czstara12/lckfb-daplink/4_docs/images/image-20240612184925933.png

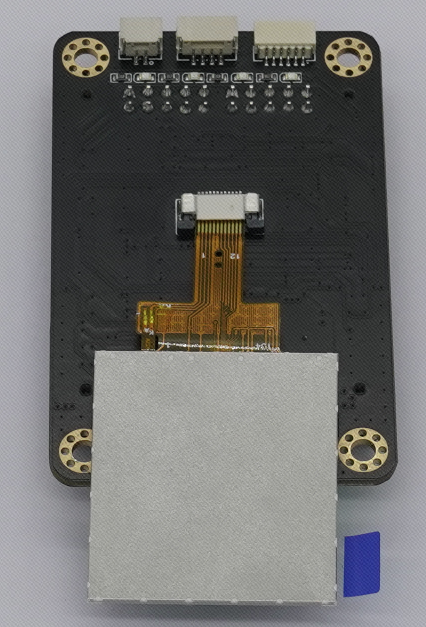
4_docs/images/image-20240612184925933.png
