czstara12/lckfb-daplink/3_3D model/下壳20240522.STEP

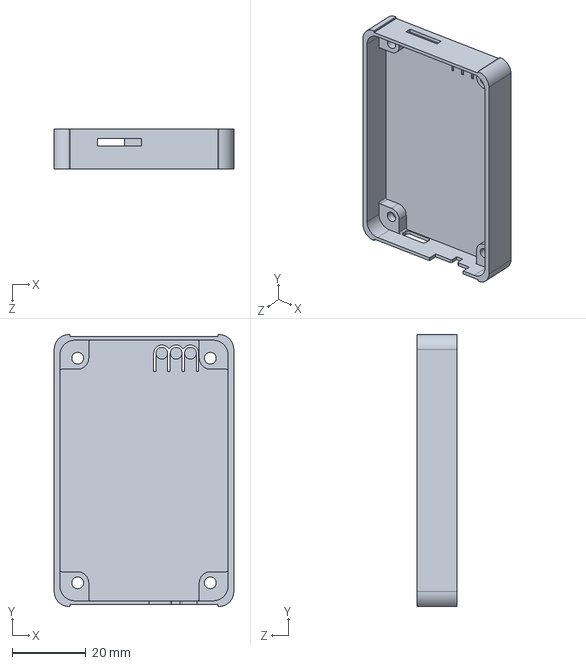
[picture p74: CAD file, 2024-06-13]
3_3D model/下壳20240522.STEP
48.6 x 73.6 x 10.9 mm
