czstara12/lckfb-daplink/3_3D model/一体按钮20240522.STEP

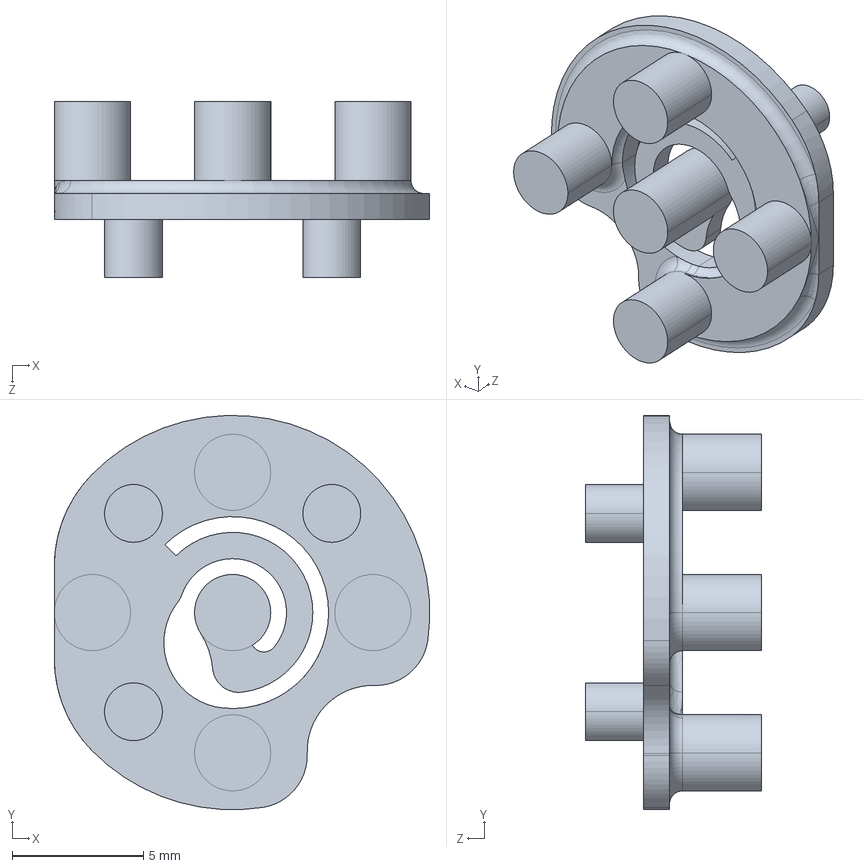
[picture p75: CAD file, 2024-06-13]
3_3D model/一体按钮20240522.STEP
14.3 x 15.0 x 6.70 mm
