czstara12/lckfb-daplink/3_3D model/上壳20240522.STEP

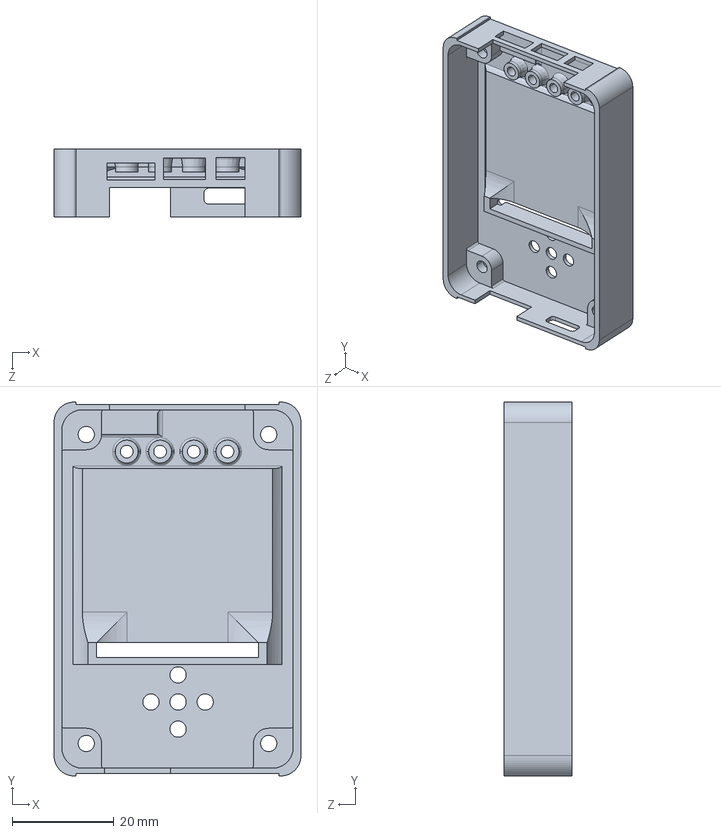
[picture p76: CAD file, 2024-06-13]
3_3D model/上壳20240522.STEP
48.6 x 73.6 x 13.3 mm
