czstara12/lckfb-daplink/4_docs/0_组装文档.md

# 物料清单

想要组装一个成品的多功能调试工具，需要准备如下物料：

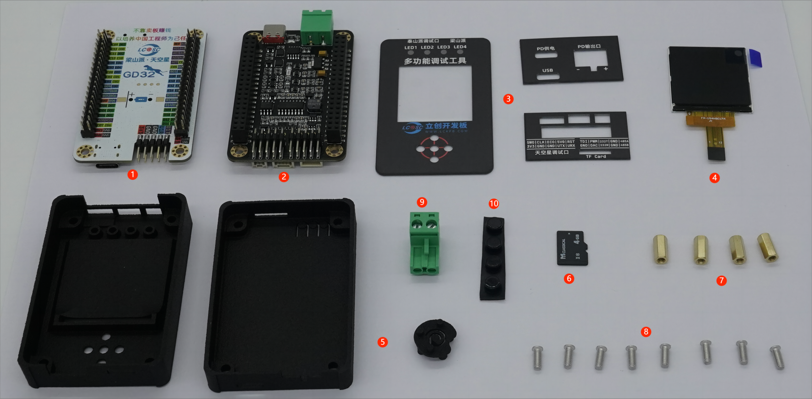
[picture p77: 4_docs/images/bom.png]
bom


| 序号 | 描述 | 获取途径 |
| :--: | :---: | :---: |
|  1 | 立创·天空星开发板-GD32F407VET6-青春版，焊接好朝下的排针。 | [购买链接](https://lckfb.com/project/detail/lckfb-lspi-skystar-gd32f407vet6-lite?param=baseInfo) |
|  2 | 立创DAPLINK调试工具扩展板 | [购买链接](https://item.szlcsc.com/24149614.html) |
|  3 | 面板  透明亚克力,底面,0.5mm,3M9448A(通用款),强遮光 | 在硬件开源地址中找到面板源文件，自行DIY外观后到[立创商城进行面板定制](https://dos.szlcsc.com/home.html) |
|  4 | 1.54寸240x240高清ips lcd显示屏-胶铁一体背光 | [购买链接](https://item.taobao.com/item.htm?spm=a1z09.2.0.0.53312e8dsg8GNX&id=675191199166&_u=c1q1nrd11cb3) |
|  5 | 3D打印外壳 【上壳】-【下壳】-【一体按钮】 | 在开源仓库找到模型文件，到[三维猴下单](https://www.jlc-3dp.cn/swhorder/#/placeOrder)，选自己喜欢的材料。 |
|  6 | TF卡 | [购买链接](https://item.szlcsc.com/8422935.html) |
|  7 | M3*10 铜柱x4 | [购买链接](https://detail.tmall.com/item.htm?id=542213588710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) |
|  8 | M3*8 头4.0 沉头螺丝x8 | [购买链接](https://detail.tmall.com/item.htm?id=756810204825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) |
|  9 | WJ2EDGK-5.08-2P 插拔式接线端子 | [购买链接](https://item.szlcsc.com/72476.html) |
|  10  | XG-0603【6*3mm】 自粘式防滑脚垫x4 | [购买链接](https://item.taobao.com/item.htm?id=626062804142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) |

# 开始组装

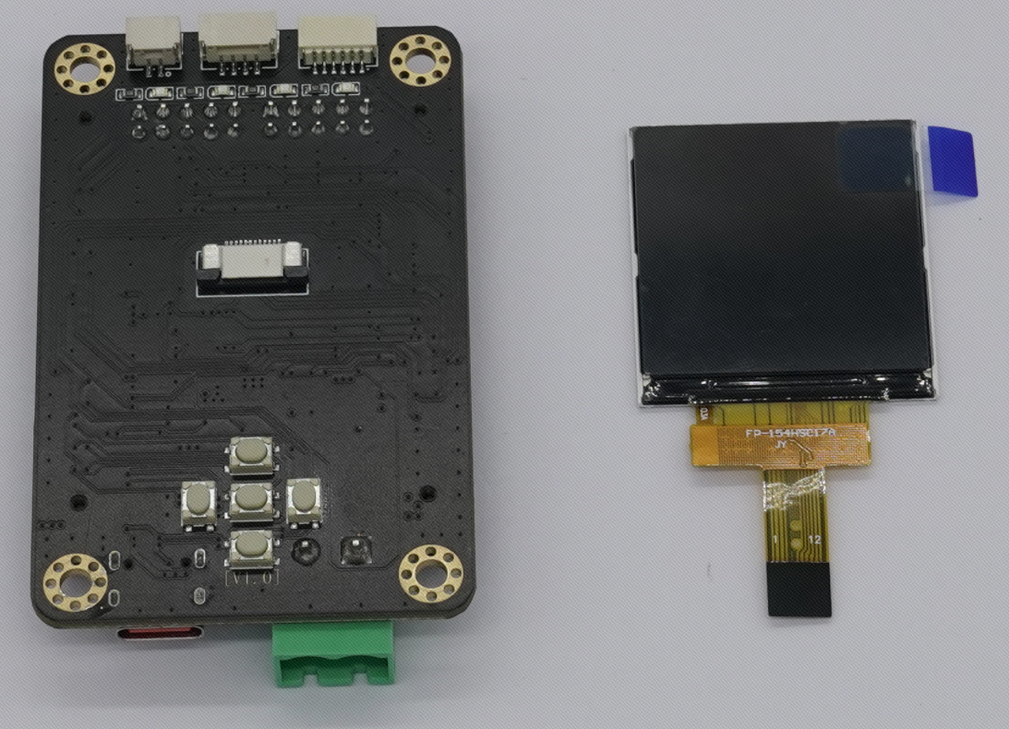
[picture p78: 4_docs/images/image-20240612184800780.png]
1. 拿出扩展板和屏幕。

2. 将屏幕FPC排线的金手指朝上插入扩展板的座子里面，插到位置后锁紧。

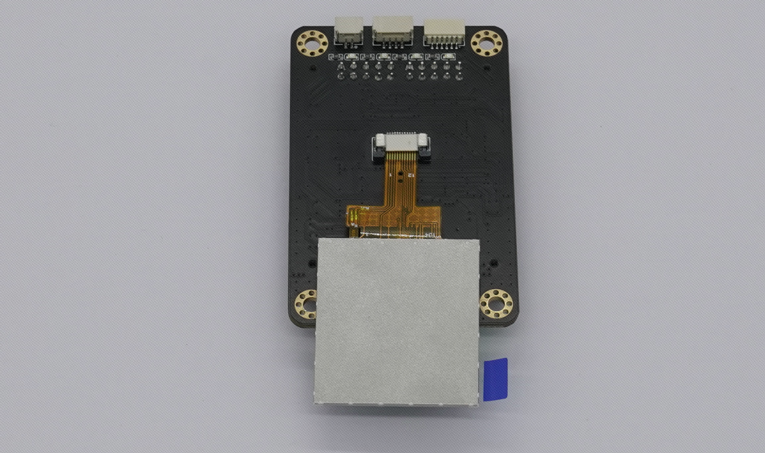
[picture p79: 4_docs/images/image-20240612192124184.png]


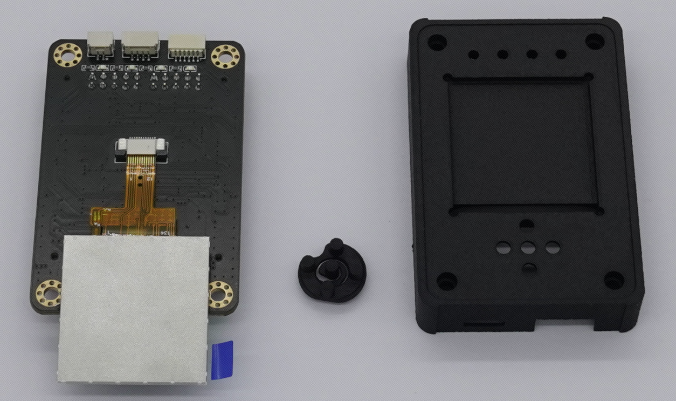
[picture p80: 4_docs/images/image-20240612185113671.png]
3. 拿出3D打印的上壳和一体按钮。

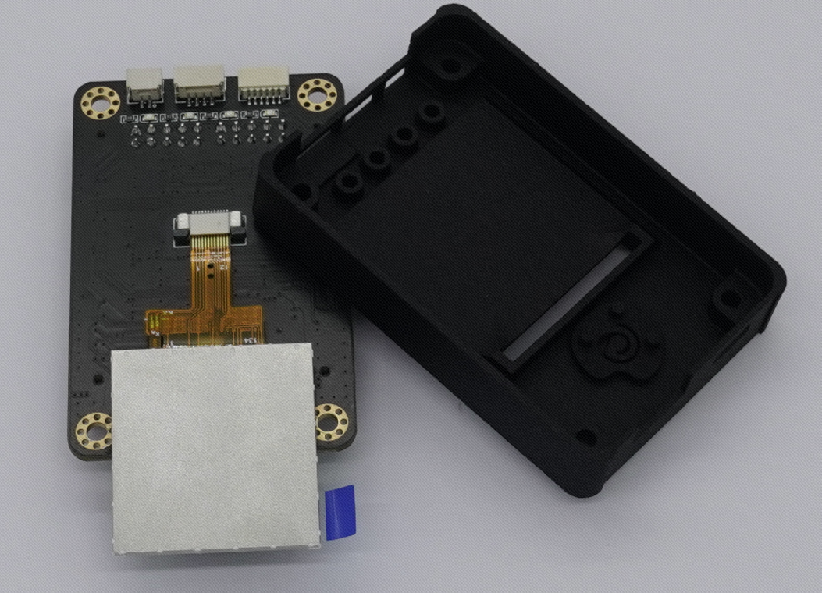
[picture p81: 4_docs/images/image-20240612185205591.png]
4. 将一体按钮如图所示塞入上壳中。

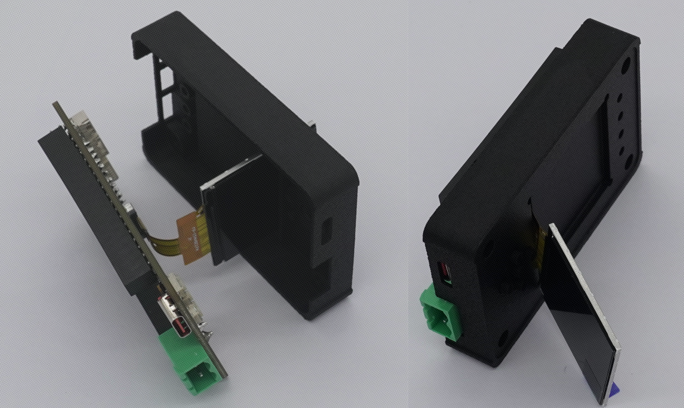
[picture p82: 4_docs/images/image-20240612185405428.png]
5. 将屏幕从上壳中间的凹槽中穿过。

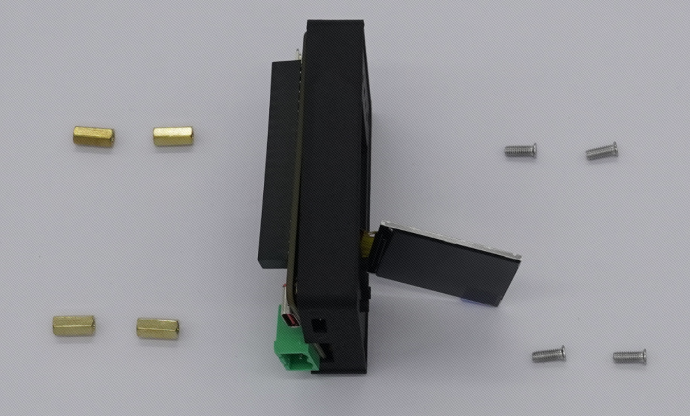
[picture p83: 4_docs/images/image-20240612185631966.png]
6. 拿出4颗【M3x10】铜柱和四颗【M3x8 头4.0】沉头螺丝。

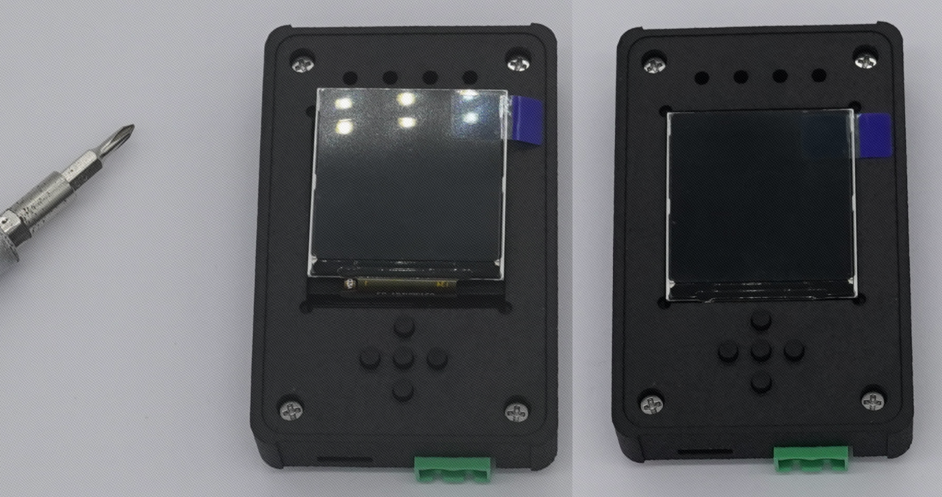
[picture p84: 4_docs/images/image-20240612185855640.png]
7. 铜柱在下，沉头螺丝在上，用十字螺丝刀将扩展板和上壳固定，固定好后如图右所示将屏幕塞入上壳凹槽内即可。

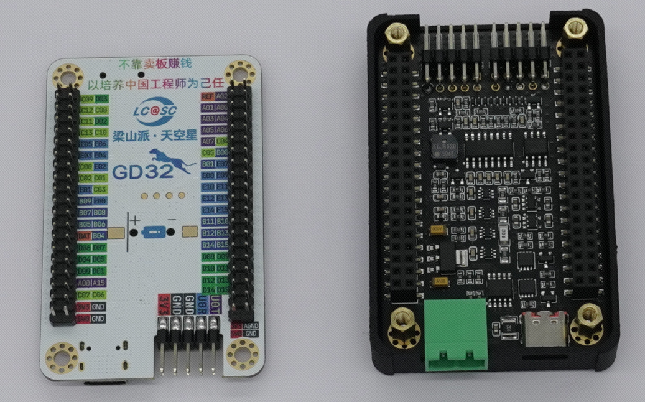
[picture p85: 4_docs/images/image-20240612185936141.png]
8. 拿出GD32版本的天空星。

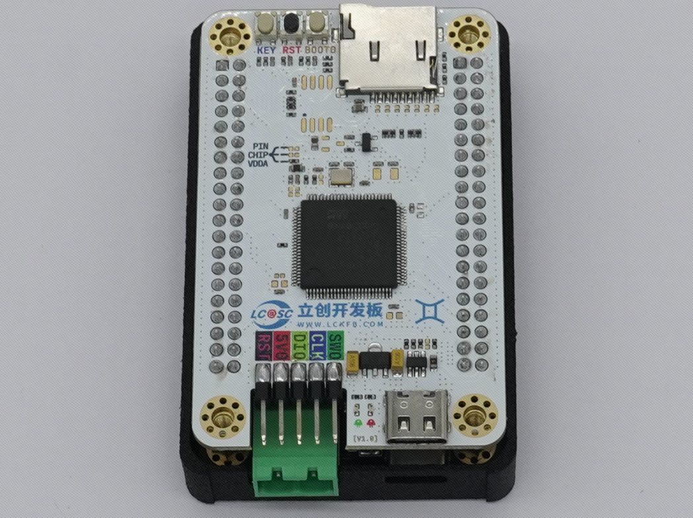
[picture p86: 4_docs/images/image-20240612190027443.png]
9. 按下图所示插入扩展板的双排母内。

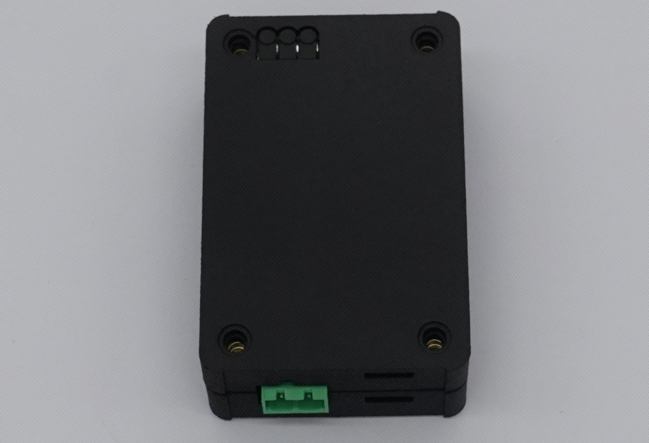
[picture p87: 4_docs/images/image-20240612190126970.png]
10. 将下壳盖到天空星上面。

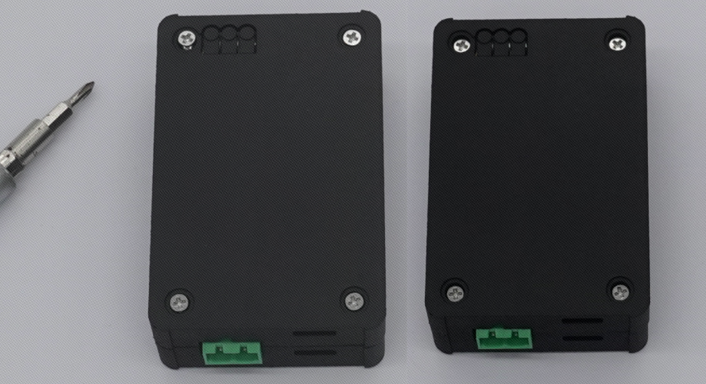
[picture p88: 4_docs/images/image-20240612190321722.png]
11. 在四个螺丝孔内放入四颗【M3x8 头4.0】沉头螺丝，并用螺丝刀拧紧。

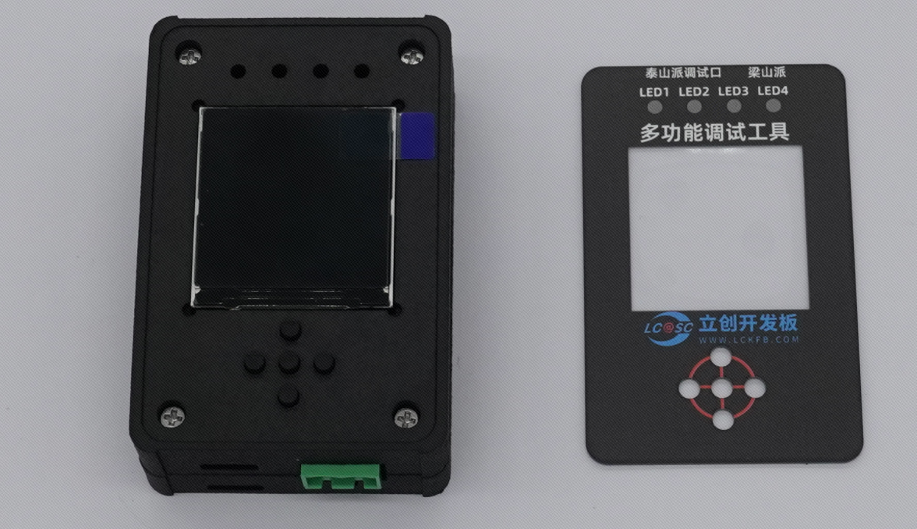
[picture p89: 4_docs/images/image-20240612190531208.png]
12. 将多功能调试器翻面，拿出正面面板。

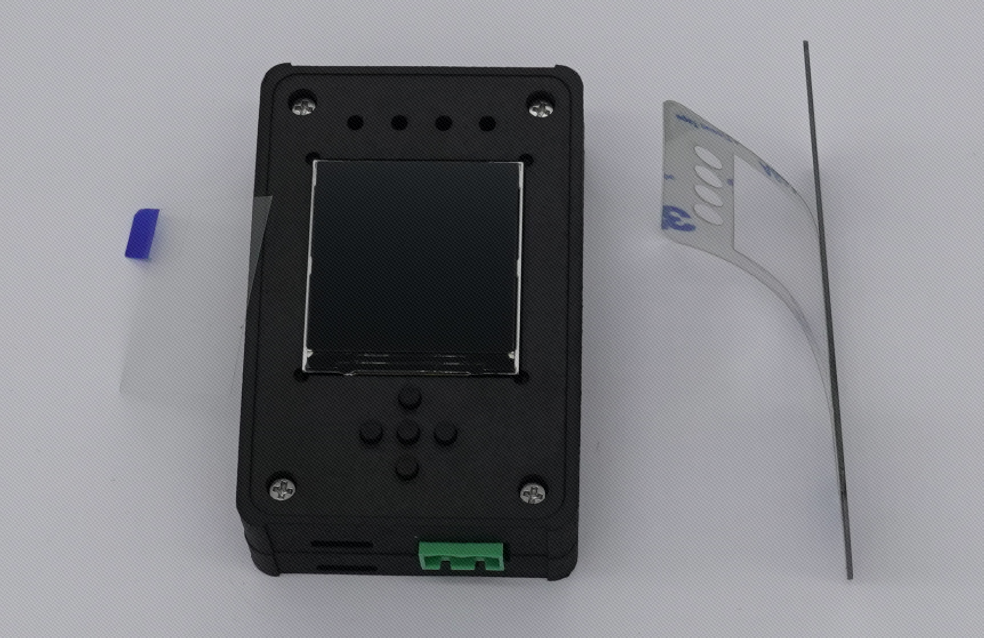
[picture p90: 4_docs/images/image-20240612190643587.png]
13. 撕掉屏幕的保护膜，撕掉面板的背胶保护膜。

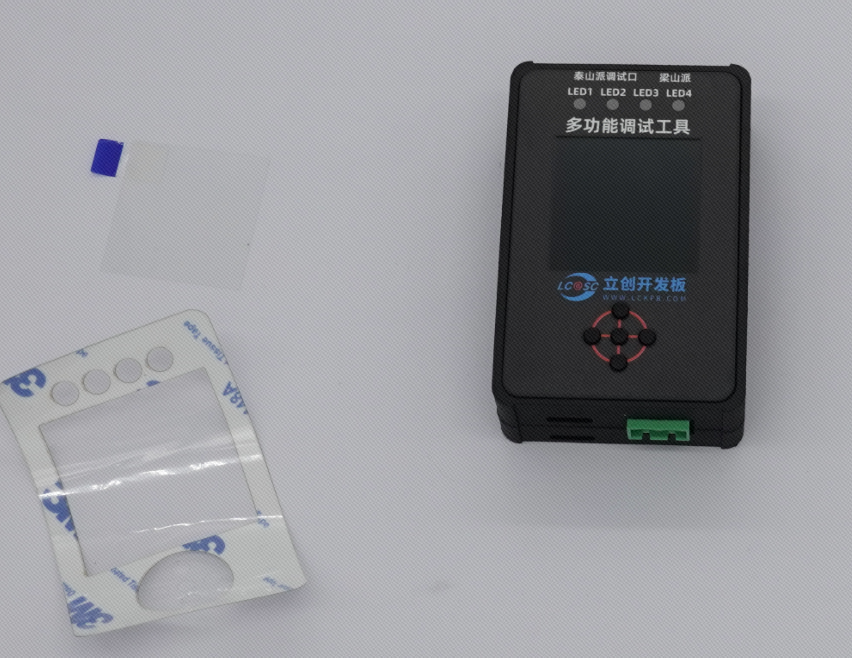
[picture p91: 4_docs/images/image-20240612190745032.png]
14. 将面板嵌入上壳的凹槽内，注意对齐按钮孔位。

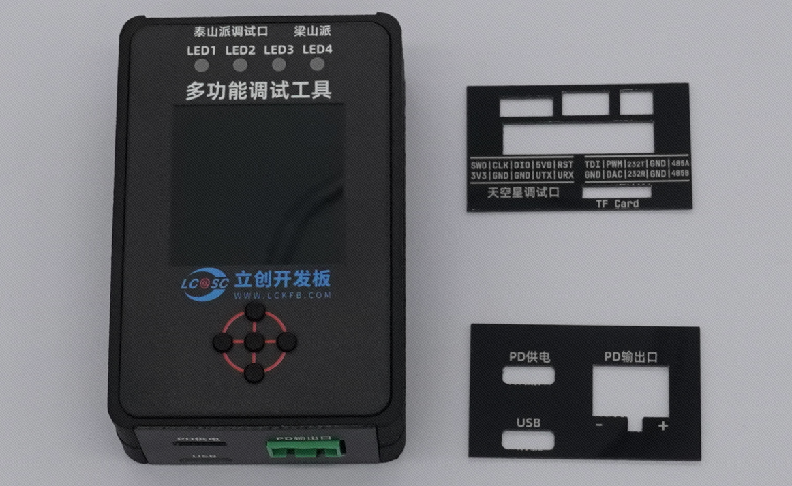
[picture p92: 4_docs/images/image-20240612191203407.png]
15. 按照之前操作，撕掉面板背胶保护膜后一并安装侧面面板。

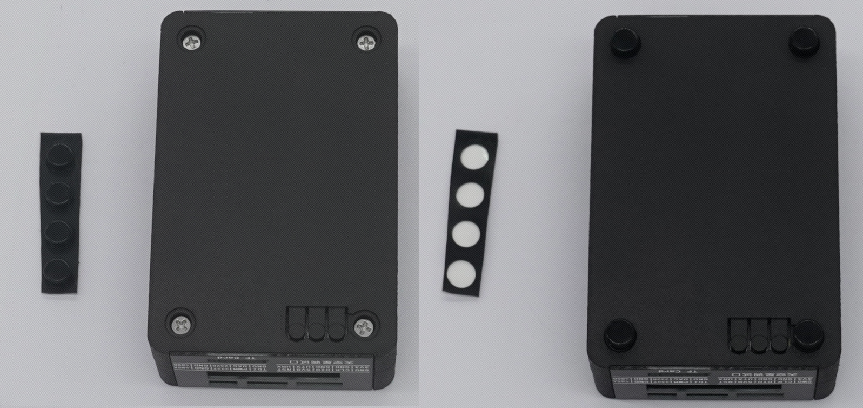
[picture p93: 4_docs/images/image-20240612191402218.png]
16. 拿出防滑脚垫，将四颗脚垫按入下壳的固定孔位中。

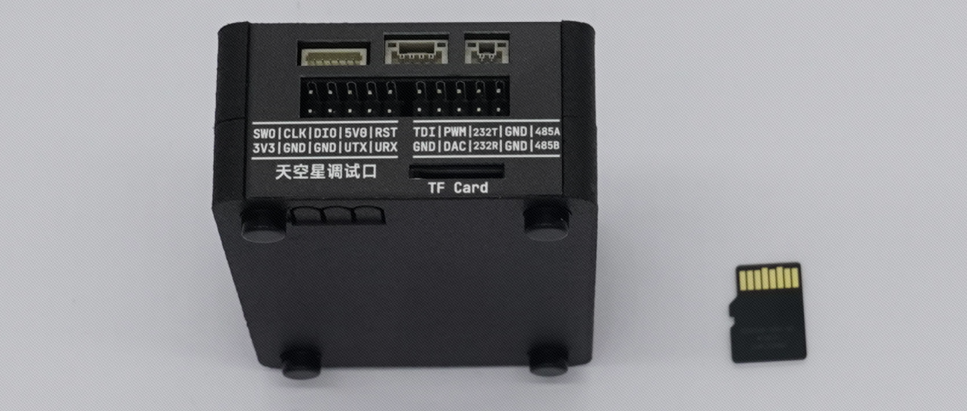
[picture p94: 4_docs/images/image-20240612191523456.png]
17. 拿出已经写入芯片下载算法和待下载固件的TF卡。

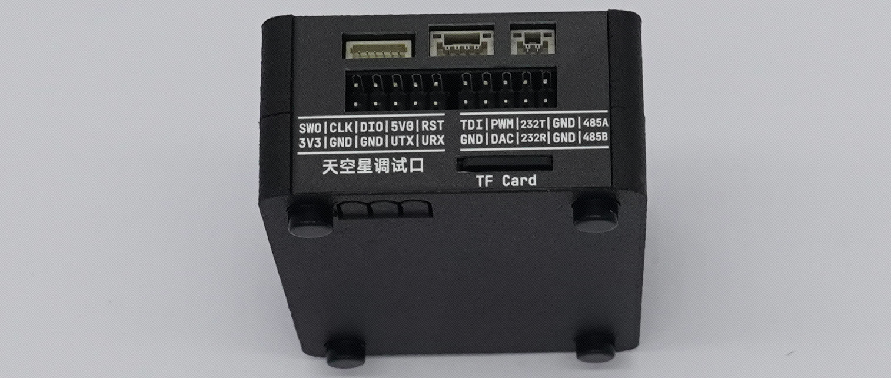
[picture p95: 4_docs/images/image-20240612191607908.png]
18. 将TF卡插入卡槽中。

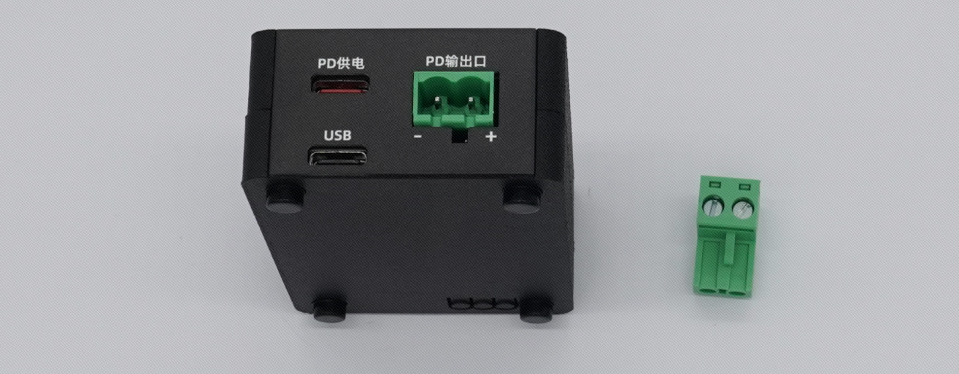
[picture p96: 4_docs/images/image-20240612191700006.png]
19. 拿出插拔式接线端子。

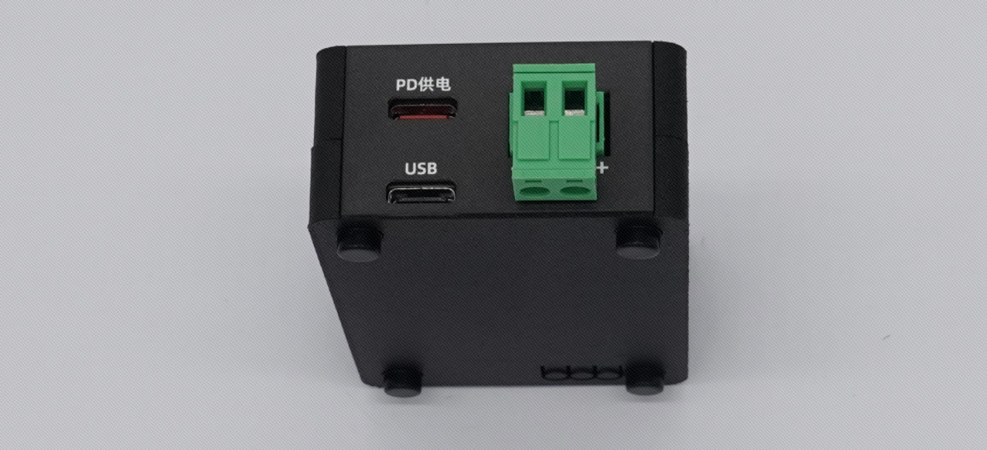
[picture p97: 4_docs/images/image-20240612191744928.png]
20. 插入PD输出口方便我们后期接线使用。

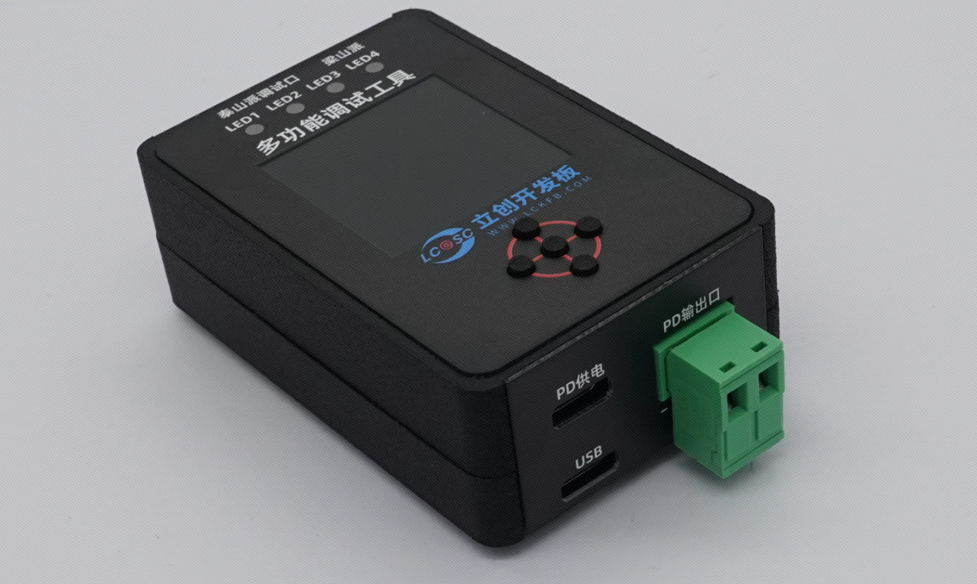
[picture p98: 4_docs/images/image-20240612191912833.png]
21. 装好后的实物图如下所示：
