czstara12/lckfb-daplink/1_Code/STM32F407/board/CubeMX_Config/CubeMX_Config.ioc

Mcu.UserName=STM32F407VETx
PA10.Signal=USART1_RX
PA11.Signal=USB_OTG_FS_DM
PA12.Signal=USB_OTG_FS_DP
PA13.Signal=SYS_JTMS-SWDIO
PA14.Signal=SYS_JTCK-SWCLK
PA3.GPIO_Label=I_PD_OUT_MEASURE2
PA3.Signal=ADCx_IN3
PB1.GPIO_Label=SPI_FLASH_CS
PB1.Signal=GPIO_Output
PA4.GPIO_Label=DAC_OUT
PA4.Signal=COMP_DAC1_group
PA9.Signal=USART1_TX
PB12.GPIO_Label=LCD_CS
PB12.Signal=GPIO_Output
PB13.GPIO_Label=LCD_SCL
PB13.Signal=SPI2_SCK
PB14.GPIO_Label=LCD_BLK
PB14.Signal=GPIO_Output
PB15.GPIO_Label=LCD_SDA
PB15.Signal=SPI2_MOSI
PB2.GPIO_Label=USER_LED
PB2.Signal=GPIO_Output
PB3.Signal=SYS_JTDO-SWO
PB9.GPIO_Label=BEEP_PWM
PB9.Signal=S_TIM4_CH4
PC0.GPIO_Label=V_5V0_OUT_MEASURE
PC0.Signal=ADCx_IN10
PC1.GPIO_Label=I_5V0_OUT_MEASURE
PC1.Signal=ADCx_IN11
PC10.Signal=SDIO_D2
PC11.Signal=SDIO_D3
PC12.Signal=SDIO_CK
PC2.GPIO_Label=V_3V3_OUT_MEASURE
PC2.Signal=ADCx_IN12
PC3.GPIO_Label=I_3V3_OUT_MEASURE
PC3.Signal=ADCx_IN13
PC4.GPIO_Label=V_PD_OUT_MEASURE
PC4.Signal=ADCx_IN14
PC5.GPIO_Label=I_PD_OUT_MEASURE1
PC5.Signal=ADCx_IN15
PC8.Signal=SDIO_D0
PC9.Signal=SDIO_D1
PD2.Signal=SDIO_CMD
PD3.GPIO_Label=SD_CARD_DET
PD3.Signal=GPIO_Input
PD6.GPIO_Label=TDO(SWO)
PD6.Signal=GPIO_Input
PD8.GPIO_Label=CDC_TX
PD8.Signal=USART3_TX
PD9.GPIO_Label=CDC_RX
PD9.Signal=USART3_RX
PE10.GPIO_Label=NRST
PE10.Signal=GPIO_Output
PE12.GPIO_Label=TDI
PE12.Signal=GPIO_Output
PE7.GPIO_Label=TCK/SWCLK
PE7.Signal=GPIO_Output
PE8.GPIO_Label=TMS/SWDIO
PE8.Signal=GPIO_Output
PE9.GPIO_Label=PWM_OUT
PE9.Signal=S_TIM1_CH1
PH0-OSC_IN.Signal=RCC_OSC_IN
PH1-OSC_OUT.Signal=RCC_OSC_OUT
