czstara12/lckfb-daplink/1_Code/STM32F407/rtconfig.h

#ifndef RT_CONFIG_H__
#define RT_CONFIG_H__

#define SOC_STM32F407VE
#define BOARD_STM32F407_LCKFB

/* RT-Thread Kernel */

/* klibc options */

/* rt_vsnprintf options */

/* end of rt_vsnprintf options */

/* rt_vsscanf options */

/* end of rt_vsscanf options */

/* rt_memset options */

/* end of rt_memset options */

/* rt_memcpy options */

/* end of rt_memcpy options */

/* rt_memmove options */

/* end of rt_memmove options */

/* rt_memcmp options */

/* end of rt_memcmp options */

/* rt_strstr options */

/* end of rt_strstr options */

/* rt_strcasecmp options */

/* end of rt_strcasecmp options */

/* rt_strncpy options */

/* end of rt_strncpy options */

/* rt_strcpy options */

/* end of rt_strcpy options */

/* rt_strncmp options */

/* end of rt_strncmp options */

/* rt_strcmp options */

/* end of rt_strcmp options */

/* rt_strlen options */

/* end of rt_strlen options */

/* rt_strnlen options */

/* end of rt_strnlen options */
/* end of klibc options */
#define RT_NAME_MAX 32
#define RT_CPUS_NR 1
#define RT_ALIGN_SIZE 8
#define RT_THREAD_PRIORITY_32
#define RT_THREAD_PRIORITY_MAX 32
#define RT_TICK_PER_SECOND 1000
#define RT_USING_OVERFLOW_CHECK
#define RT_USING_HOOK
#define RT_HOOK_USING_FUNC_PTR
#define RT_USING_IDLE_HOOK
#define RT_IDLE_HOOK_LIST_SIZE 4
#define IDLE_THREAD_STACK_SIZE 1024

/* kservice options */

/* end of kservice options */
#define RT_USING_DEBUG
#define RT_DEBUGING_ASSERT
#define RT_DEBUGING_COLOR
#define RT_DEBUGING_CONTEXT

/* Inter-Thread communication */

#define RT_USING_SEMAPHORE
#define RT_USING_MUTEX
#define RT_USING_EVENT
#define RT_USING_MAILBOX
#define RT_USING_MESSAGEQUEUE
/* end of Inter-Thread communication */

/* Memory Management */

#define RT_USING_MEMPOOL
#define RT_USING_SMALL_MEM
#define RT_USING_SMALL_MEM_AS_HEAP
#define RT_USING_HEAP
/* end of Memory Management */
#define RT_USING_DEVICE
#define RT_USING_DEVICE_OPS
#define RT_USING_CONSOLE
#define RT_CONSOLEBUF_SIZE 128
#define RT_CONSOLE_DEVICE_NAME "uart1"
#define RT_VER_NUM 0x50201
#define RT_BACKTRACE_LEVEL_MAX_NR 32
/* end of RT-Thread Kernel */
#define RT_USING_HW_ATOMIC
#define RT_USING_CPU_FFS
#define ARCH_ARM
#define ARCH_ARM_CORTEX_M
#define ARCH_ARM_CORTEX_M4

/* RT-Thread Components */

#define RT_USING_COMPONENTS_INIT
#define RT_USING_USER_MAIN
#define RT_MAIN_THREAD_STACK_SIZE 2048
#define RT_MAIN_THREAD_PRIORITY 10
#define RT_USING_LEGACY
#define RT_USING_MSH
#define RT_USING_FINSH
#define FINSH_USING_MSH
#define FINSH_THREAD_NAME "tshell"
#define FINSH_THREAD_PRIORITY 20
#define FINSH_THREAD_STACK_SIZE 4096
#define FINSH_USING_HISTORY
#define FINSH_HISTORY_LINES 5
#define FINSH_USING_SYMTAB
#define FINSH_CMD_SIZE 80
#define MSH_USING_BUILT_IN_COMMANDS
#define FINSH_USING_DESCRIPTION
#define FINSH_ARG_MAX 10
#define FINSH_USING_OPTION_COMPLETION

/* DFS: device virtual file system */

#define RT_USING_DFS
#define DFS_USING_POSIX
#define DFS_USING_WORKDIR
#define DFS_FD_MAX 16
#define RT_USING_DFS_V1
#define DFS_FILESYSTEMS_MAX 4
#define DFS_FILESYSTEM_TYPES_MAX 4
#define RT_USING_DFS_ELMFAT

/* elm-chan's FatFs, Generic FAT Filesystem Module */

#define RT_DFS_ELM_CODE_PAGE 437
#define RT_DFS_ELM_WORD_ACCESS
#define RT_DFS_ELM_USE_LFN_3
#define RT_DFS_ELM_USE_LFN 3
#define RT_DFS_ELM_LFN_UNICODE_0
#define RT_DFS_ELM_LFN_UNICODE 0
#define RT_DFS_ELM_MAX_LFN 255
#define RT_DFS_ELM_DRIVES 2
#define RT_DFS_ELM_MAX_SECTOR_SIZE 4096
#define RT_DFS_ELM_REENTRANT
#define RT_DFS_ELM_MUTEX_TIMEOUT 3000
#define RT_DFS_ELM_USE_EXFAT
/* end of elm-chan's FatFs, Generic FAT Filesystem Module */
#define RT_USING_DFS_DEVFS
#define RT_USING_DFS_ROMFS
/* end of DFS: device virtual file system */
#define RT_USING_FAL
#define FAL_USING_DEBUG
#define FAL_PART_HAS_TABLE_CFG
#define FAL_USING_SFUD_PORT
#define FAL_USING_NOR_FLASH_DEV_NAME "W25Q32"

/* Device Drivers */

#define RT_USING_DEVICE_IPC
#define RT_UNAMED_PIPE_NUMBER 64
#define RT_USING_SERIAL
#define RT_USING_SERIAL_V1
#define RT_SERIAL_USING_DMA
#define RT_SERIAL_RB_BUFSZ 64
#define RT_USING_CPUTIME
#define RT_USING_CPUTIME_CORTEXM
#define CPUTIME_TIMER_FREQ 0
#define RT_USING_DAC
#define RT_USING_PWM
#define RT_USING_MTD_NOR
#define RT_USING_RTC
#define RT_USING_SDIO
#define RT_SDIO_STACK_SIZE 512
#define RT_SDIO_THREAD_PRIORITY 15
#define RT_MMCSD_STACK_SIZE 2048
#define RT_MMCSD_THREAD_PRIORITY 22
#define RT_MMCSD_MAX_PARTITION 16
#define RT_USING_SPI
#define RT_USING_SFUD
#define RT_SFUD_USING_SFDP
#define RT_SFUD_SPI_MAX_HZ 50000000
#define RT_USING_BLK

/* Partition Types */

#define RT_BLK_PARTITION_DFS
#define RT_BLK_PARTITION_EFI
/* end of Partition Types */
#define RT_USING_PIN
#define RT_USING_KTIME
#define RT_USING_HWTIMER
/* end of Device Drivers */

/* C/C++ and POSIX layer */

/* ISO-ANSI C layer */

/* Timezone and Daylight Saving Time */

#define RT_LIBC_USING_LIGHT_TZ_DST
#define RT_LIBC_TZ_DEFAULT_HOUR 8
#define RT_LIBC_TZ_DEFAULT_MIN 0
#define RT_LIBC_TZ_DEFAULT_SEC 0
/* end of Timezone and Daylight Saving Time */
/* end of ISO-ANSI C layer */

/* POSIX (Portable Operating System Interface) layer */

#define RT_USING_POSIX_FS
#define RT_USING_POSIX_DEVIO
#define RT_USING_POSIX_STDIO
#define RT_USING_POSIX_POLL
#define RT_USING_POSIX_TERMIOS
#define RT_USING_POSIX_DELAY

/* Interprocess Communication (IPC) */


/* Socket is in the 'Network' category */

/* end of Interprocess Communication (IPC) */
/* end of POSIX (Portable Operating System Interface) layer */
/* end of C/C++ and POSIX layer */

/* Network */

/* end of Network */

/* Memory protection */

/* end of Memory protection */

/* Utilities */

#define RT_USING_ULOG
#define ULOG_OUTPUT_LVL_E
#define ULOG_OUTPUT_LVL 3
#define ULOG_ASSERT_ENABLE
#define ULOG_LINE_BUF_SIZE 128

/* log format */

#define ULOG_USING_COLOR
#define ULOG_OUTPUT_TIME
#define ULOG_OUTPUT_LEVEL
#define ULOG_OUTPUT_TAG
/* end of log format */
#define ULOG_BACKEND_USING_CONSOLE
/* end of Utilities */

/* Using USB legacy version */

/* end of Using USB legacy version */
/* end of RT-Thread Components */

/* RT-Thread Utestcases */

/* end of RT-Thread Utestcases */

/* RT-Thread online packages */

/* IoT - internet of things */


/* Wi-Fi */

/* Marvell WiFi */

/* end of Marvell WiFi */

/* Wiced WiFi */

/* end of Wiced WiFi */

/* CYW43012 WiFi */

/* end of CYW43012 WiFi */

/* BL808 WiFi */

/* end of BL808 WiFi */

/* CYW43439 WiFi */

/* end of CYW43439 WiFi */
/* end of Wi-Fi */

/* IoT Cloud */

/* end of IoT Cloud */
/* end of IoT - internet of things */

/* security packages */

/* end of security packages */

/* language packages */

/* JSON: JavaScript Object Notation, a lightweight data-interchange format */

/* end of JSON: JavaScript Object Notation, a lightweight data-interchange format */

/* XML: Extensible Markup Language */

/* end of XML: Extensible Markup Language */
#define PKG_USING_MICROPYTHON

/* Hardware Module */

/* end of Hardware Module */

/* System Module */

/* end of System Module */

/* Tools Module */

/* end of Tools Module */

/* Network Module */

/* end of Network Module */

/* User Extended Module */

/* end of User Extended Module */
#define PKG_MICROPYTHON_HEAP_SIZE 8192
#define PKG_USING_MICROPYTHON_V11300
#define PKG_MICROPYTHON_VER_NUM 0x11300
/* end of language packages */

/* multimedia packages */

/* LVGL: powerful and easy-to-use embedded GUI library */

#define PKG_USING_LVGL
#define PKG_LVGL_THREAD_PRIO 20
#define PKG_LVGL_THREAD_STACK_SIZE 4096
#define PKG_LVGL_DISP_REFR_PERIOD 10
#define PKG_LVGL_USING_V080311
#define PKG_LVGL_VER_NUM 0x080311
/* end of LVGL: powerful and easy-to-use embedded GUI library */

/* u8g2: a monochrome graphic library */

/* end of u8g2: a monochrome graphic library */
/* end of multimedia packages */

/* tools packages */

#define PKG_USING_MEM_SANDBOX
#define PKG_USING_MEM_SANDBOX_LATEST_VERSION
/* end of tools packages */

/* system packages */

/* enhanced kernel services */

/* end of enhanced kernel services */

/* acceleration: Assembly language or algorithmic acceleration packages */

/* end of acceleration: Assembly language or algorithmic acceleration packages */

/* CMSIS: ARM Cortex-M Microcontroller Software Interface Standard */

/* end of CMSIS: ARM Cortex-M Microcontroller Software Interface Standard */

/* Micrium: Micrium software products porting for RT-Thread */

/* end of Micrium: Micrium software products porting for RT-Thread */
#define PKG_USING_PERF_COUNTER
#define PKG_USING_PERF_COUNTER_V2241
#define PKG_USING_LITTLEFS
#define PKG_USING_LITTLEFS_V2112
#define LFS_READ_SIZE 256
#define LFS_PROG_SIZE 256
#define LFS_BLOCK_SIZE 4096
#define LFS_NO_DEBUG
#define LFS_CACHE_SIZE 256
#define LFS_BLOCK_CYCLES 500
#define LFS_THREADSAFE
#define LFS_LOOKAHEAD_MAX 128
#define RT_DEF_LFS_DRIVERS 1
/* end of system packages */

/* peripheral libraries and drivers */

/* HAL & SDK Drivers */

/* STM32 HAL & SDK Drivers */

#define SDIO_MAX_FREQ 24000000
/* end of STM32 HAL & SDK Drivers */

/* Infineon HAL Packages */

/* end of Infineon HAL Packages */

/* Kendryte SDK */

/* end of Kendryte SDK */

/* MM32 HAL & SDK Drivers */

/* end of MM32 HAL & SDK Drivers */

/* WCH HAL & SDK Drivers */

/* end of WCH HAL & SDK Drivers */

/* AT32 HAL & SDK Drivers */

/* end of AT32 HAL & SDK Drivers */

/* HC32 DDL Drivers */

/* end of HC32 DDL Drivers */

/* NXP HAL & SDK Drivers */

/* end of NXP HAL & SDK Drivers */

/* NUVOTON Drivers */

/* end of NUVOTON Drivers */

/* GD32 Drivers */

/* end of GD32 Drivers */

/* HPMicro SDK */

/* end of HPMicro SDK */

/* FT32 HAL & SDK Drivers */

/* end of FT32 HAL & SDK Drivers */

/* NOVOSNS Drivers */

/* end of NOVOSNS Drivers */

/* N32 Drivers */

/* end of N32 Drivers */
/* end of HAL & SDK Drivers */

/* sensors drivers */

/* end of sensors drivers */

/* touch drivers */

/* end of touch drivers */
#define PKG_USING_ST7789
#define PKG_ST_7789_SPI_BUS_NAME "spi2"
#define PKG_ST_7789_SPI_DEVICE_NAME "spi20"
#define PKG_ST_7789_WIDTH 240
#define PKG_ST_7789_HEIGHT 240
#define PKG_ST_7789_DC_PIN 79
#define PKG_ST_7789_RES_PIN 78
#define PKG_ST_7789_CS_PIN 28
#define PKG_ST_7789_BLK_PIN 30
/* end of peripheral libraries and drivers */

/* AI packages */

/* end of AI packages */

/* Signal Processing and Control Algorithm Packages */

/* end of Signal Processing and Control Algorithm Packages */

/* miscellaneous packages */

/* project laboratory */

/* end of project laboratory */

/* samples: kernel and components samples */

/* end of samples: kernel and components samples */

/* entertainment: terminal games and other interesting software packages */

/* end of entertainment: terminal games and other interesting software packages */
#define PKG_USING_OPTPARSE
#define PKG_USING_OPTPARSE_LATEST_VERSION
#define PKG_USING_FLEXIBLE_BUTTON
#define PKG_USING_FLEXIBLE_BUTTON_V100
#define PKG_USING_VI
#define VI_SANDBOX_SIZE_KB 32
#define VI_MAX_LEN 256
#define VI_ENABLE_COLON
#define VI_ENABLE_COLON_EXPAND
#define VI_ENABLE_YANKMARK
#define VI_ENABLE_SEARCH
#define VI_ENABLE_DOT_CMD
#define VI_ENABLE_READONLY
#define VI_ENABLE_SETOPTS
#define VI_ENABLE_SET
#define VI_ENABLE_WIN_RESIZE
#define VI_ENABLE_VI_ASK_TERMINAL
#define VI_ENABLE_UNDO
#define VI_ENABLE_UNDO_QUEUE
#define VI_UNDO_QUEUE_MAX 256
#define VI_ENABLE_VERBOSE_STATUS
#define PKG_USING_VI_LATEST_VERSION
/* end of miscellaneous packages */

/* Arduino libraries */


/* Projects and Demos */

/* end of Projects and Demos */

/* Sensors */

/* end of Sensors */

/* Display */

/* end of Display */

/* Timing */

/* end of Timing */

/* Data Processing */

/* end of Data Processing */

/* Data Storage */

/* Communication */

/* end of Communication */

/* Device Control */

/* end of Device Control */

/* Other */

/* end of Other */

/* Signal IO */

/* end of Signal IO */

/* Uncategorized */

/* end of Arduino libraries */
/* end of RT-Thread online packages */
#define SOC_FAMILY_STM32
#define SOC_SERIES_STM32F4

/* Hardware Drivers Config */

/* Onboard Peripheral Drivers */

#define BSP_USING_SPI_FLASH
#define BSP_USING_FS
#define BSP_USING_SDCARD_FATFS
#define BSP_USING_FLASH_LITTLEFS
#define BSP_USING_FLASH_FS_AUTO_MOUNT
#define BSP_USING_FAL
/* end of Onboard Peripheral Drivers */

/* On-chip Peripheral Drivers */

#define BSP_USING_GPIO
#define BSP_USING_UART
#define BSP_USING_UART1
#define BSP_USING_TIM
#define BSP_USING_TIM1
#define BSP_USING_TIM4
#define BSP_USING_PWM
#define BSP_USING_PWM1
#define BSP_USING_PWM1_CH1
#define BSP_USING_PWM4
#define BSP_USING_PWM4_CH4
#define BSP_USING_ON_CHIP_FLASH
#define BSP_USING_SPI
#define BSP_USING_SPI1
#define BSP_SPI1_TX_USING_DMA
#define BSP_SPI1_RX_USING_DMA
#define BSP_USING_SPI2
#define BSP_USING_DAC
#define BSP_USING_DAC1
#define BSP_USING_SDIO
/* end of On-chip Peripheral Drivers */
/* end of Hardware Drivers Config */

#endif
