czstara12/lckfb-daplink/1_Code/STM32F407/applications/bsp_beep.c

/*
* 梁山派软硬件资料与相关扩展板软硬件资料官网全部开源
* 开发板官网：www.lckfb.com
* 技术支持常驻论坛，任何技术问题欢迎随时交流学习
* 立创论坛：club.szlcsc.com
* 关注bilibili账号：【立创开发板】，掌握我们的最新动态！
* 不靠卖板赚钱，以培养中国工程师为己任
* Change Logs:
* Date           Author       Notes
* 2024-02-22     LCKFB-yzh    first version
*/
#include <stdio.h>
#include <board.h>
#include <bsp_beep.h>
#include <rtdevice.h>

#define BEEP_PWM_DEV_NAME        "pwm4"  /* PWM设备名称 */
#define BEEP_PWM_DEV_CHANNEL     4       /* PWM通道 */

struct rt_device_pwm *beep_pwm_dev;      /* PWM设备句柄 */

/**
 -  @brief  蜂鸣器定时器初始化
 -  @note   None
 -  @param  None
 -  @retval None
   */
static void beep_pwm_init(void)
{
	 rt_uint32_t period, pulse;
	
	period = 53392;
	pulse = 26696;
    /* 查找设备 */
    beep_pwm_dev = (struct rt_device_pwm *)rt_device_find(BEEP_PWM_DEV_NAME);
	if (beep_pwm_dev == RT_NULL)
    {
        rt_kprintf("beep_pwm_dev find failed! can't find %s device!\n", BEEP_PWM_DEV_NAME);
        return;
    }
	/* 设置PWM周期和脉冲宽度默认值 */
    rt_pwm_set(beep_pwm_dev, BEEP_PWM_DEV_CHANNEL, period, pulse);
    /* 使能设备 */
    rt_pwm_disable(beep_pwm_dev, BEEP_PWM_DEV_CHANNEL);

    return;
}

/**
 -  @brief  蜂鸣器的PWM频率和周期设置
 -  @note   None
-  @param  _tone_freq:PWM频率，_volume:PWM占空比，100时蜂鸣器声音最大，代表PWM占空比为50%
 -  @retval None
   */
void buzzer_beep_set(uint16_t _tone_freq, uint8_t _volume)
{
	uint32_t _period,_pulse;
    _period = (1000000000ULL/_tone_freq);
    _pulse = ((_volume/100.0f)*_period)/2;

	if((_tone_freq == 0)||(_volume == 0))
	{
		rt_pwm_disable(beep_pwm_dev, BEEP_PWM_DEV_CHANNEL);
		return;
	}
	
	/* 设置PWM周期和脉冲宽度默认值 */
    rt_pwm_set(beep_pwm_dev, BEEP_PWM_DEV_CHANNEL, _period, _pulse);
    /* 使能设备 */
    rt_pwm_enable(beep_pwm_dev, BEEP_PWM_DEV_CHANNEL);
}


/**
 -  @brief  蜂鸣器引脚和定时器初始化
 -  @note   None
 -  @param  None
 -  @retval RT_EOK
   */
int beep_init(void)
{
    beep_pwm_init();
    return 1;
}
INIT_APP_EXPORT(beep_init);
