czstara12/lckfb-daplink/(commit log)

2024-06-13 -添加编译缺少的文件
2024-06-14 添加stm32f1支持
2024-07-18 -防止用户在动画界面就按下确认键，导致提前调用未初始化的界面
2024-07-18 -调整文件结构
    [code-format.cfg, kconfig-language.txt, kconfig.txt]
2024-07-18 -加入天空星STM32版本的daplink扩展板软件
    [code-format.cfg, kconfig-language.txt, kconfig.txt]
2024-07-29 -修复STM32版天空星偶现的无法正常点亮屏幕的问题。
2026-07-11 fix(build): 修复 GCC 构建兼容性
    [DAP_config.h, bsp_dac.h, numeric_tools.c]
2026-07-11 docs(agent): 添加 STM32F407 贡献指南
2026-07-11 fix(ui): 修复 PWM 获取函数的 extern 声明
2026-07-11 fix(build): 修正 GCC 内存段布局与构建配置
2026-07-11 feat(storage): 使用 W25N01GV 和 UFFS 替换 NOR Flash
2026-07-11 feat(runtime): 添加运行负载 LED 指示
    通过 RT-Thread idle hook 统计空闲计数，使用 PB2 根据估算负载调整闪烁频率。
    新增 pi_load 前台测试命令用于制造 CPU 负载，便于验证指示效果。
2026-07-12 fix(storage): 调整 NAND CS 与 DAC 输出引脚
    将 W25N01GV 片选迁移到 PA1，并将 DAC 输出切换到 PA4 的 DAC1 通道。同步更新 DMA1 Stream5、中断处理及 CubeMX 配置，解除 SPI1 时钟与 DAC 输出冲突。
    [CubeMX_Config.ioc, bsp_dac.h, main.c, main.h]
2026-07-12 refactor(uffs): 改用官方静态内存分配器
    移除自制 CCM 动态分配与系统堆回退，使用 UFFS_STATIC_BUFF_SIZE 计算 48064 字节静态池并放入 CCM。缩减页缓存参数，使 UFFS 运行内存完整驻留 CCM。
2026-07-12 perf(startup): 将 UFFS 挂载移入主线程
    取消 INIT_APP 阶段同步挂载和固定延时，改由 main 主线程调用 filesystem_mount。挂载扫描期间 Shell、LVGL 和 USB 等独立线程可继续运行。
2026-07-12 refactor(memory): 优化 CCM 与 SRAM 内存布局
    将 CPU 专用缓冲区迁移至 CCM，并在启动阶段清零对应段。\n将 UFFS NAND 数据缓冲区保留在 DMA 可访问的 SRAM。\n\nSigned-off-by: czstara12
2026-07-12 feat(spi): 启用 SPI1 DMA 传输
    配置 SPI1 收发 DMA 通道并完善驱动完成回调。\n使用虚拟发送缓冲区支持 DMA 只读传输，同时避免影响 SPI2 LCD 片选。\n\nSigned-off-by: czstara12
2026-07-12 docs(memory): 记录主堆保守优化设计
    明确模块资源收缩、线程栈迁移和 CCM 静态容量约束。\n\nSigned-off-by: czstara12
2026-07-12 docs(memory): 添加主堆优化实施计划
    拆分资源收缩、线程栈迁移和内存布局验证步骤。\n\nSigned-off-by: czstara12
2026-07-12 refactor(memory): 提升主堆可用空间
    保守收缩 UFFS 与 LVGL 资源，将常驻线程栈、控制块和 CPU-only 静态对象迁入 CCM。\n\n启动后主堆收益下限约 19.4 KiB，CCM 保留 1.9 KiB，DMA 缓冲继续位于 SRAM1。\n\nSigned-off-by: czstara12
2026-07-12 docs(memory): 删除主堆内存优化设计文档
2026-07-13 refactor(memory): 优化内存并预留32KB引导区
    收缩静态资源并将非DMA线程栈和串口缓冲区迁移到CCM NOLOAD段。\n简化About页面、移除未使用图片并合并LVGL字体资源。\n统一GCC、MDK和IAR应用地址至0x08008000并重定位向量表。\n\nSigned-off-by: czstara12
2026-07-13 feat(sdcard): 启用 SD 卡热插拔挂载
    启用板载 SD 卡 FATFS 支持，并由监测线程统一挂载到 /sdcard。\n\n补充挂载与卸载接口的 Doxygen 注释和错误返回语义。\n\nSigned-off-by: czstara12
2026-07-13 refactor(memory): 统一 CCM 内存布局
    合并 CCM 数据与未初始化段，并将剩余空间自动用作主栈。\n\n同步启动初始化、USB 缓冲区和 LVGL 线程栈的段配置，同时让链接目标显式依赖链接脚本。\n\nSigned-off-by: czstara12
2026-07-13 refactor(memory): 将默认路径数据移至运行期初始化
    将 DFS 工作目录和脱机下载默认路径由静态数据段迁移至 BSS，并在对应初始化函数中恢复默认值。
2026-07-13 fix(ui): 缩小路径与监视文本字号
    将文件浏览器、脱机下载路径及串口监视区域的 Montserrat 字体统一调整为 12px，改善小屏内容显示。
2026-07-13 feat(monitor): 添加运行负载统计与 LED 指示
    基于 CPU time 和调度钩子统计系统及线程负载。\n主循环以 LED 灯条和 PB2 闪烁频率展示最近采样结果。\n修复采样临界区外读取周期计数导致的差值下溢。
    [main.c, rtconfig.h, runtime_load_indicator.c, runtime_load_indicator.h]
2026-07-13 fix(storage): 提升 NAND 文件系统访问可靠性
    每次 SPI DMA 传输前重置完成量，并在超时时中止 HAL 传输。\n向 UFFS 传递 NAND 读取错误，同时补全挂载根目录的 stat 结果。
2026-07-18 chore(build): 补充生成文件忽略规则
    忽略 UF2 输出及字体工具的本地依赖缓存。
2026-07-18 perf(ui): 按需裁剪 LVGL 字体资源
    扫描界面静态文本并保留动态字符集，通过现有文件清单限定参与构建的字体源文件。
2026-07-18 feat(build): 生成 UF2 固件产物
    构建后将应用 BIN 转换为带 STM32F407 地址和系列标识的 UF2 文件。
2026-07-18 fix(build): 修复 GCC 探测正则转义警告
    使用原始字符串表达式，避免新版 Python 报告无效转义。
2026-07-18 feat(ui): 启动时直接进入功能菜单
2026-07-18 fix(ui): 恢复原字体并补全动态字模
2026-07-24 fix(linker): 调整 SRAM 内存分配
    将常规 data 和 bss 默认放入 RAM2，并把 DMA 与大缓冲区明确放入 RAM1。\n恢复 UFFS 动态内存分配，清理冗余的段与对齐属性。
    [dap_main.c, lv_rt_thread_port.c, offline_download_thread.c, sd_card_thread.c]
2026-07-24 refactor(ui): 删除页面虚拟小键盘
2026-07-26 feat(ui): 使用数字轮盘设置 PWM 参数
2026-07-26 feat(ui): 使用轮盘设置 DAC 波形与频率
2026-07-28 fix(ui): 修复页面淡入中间帧异常
2026-07-28 fix(sdcard): 修复热插拔挂载流程
    复用现有 MMC/SD Host 重新探测插卡设备，避免重复初始化 SDIO。\n\n拔卡时先卸载文件系统再注销块设备，并避免重复挂载和卸载。
    [sd_card_thread.c]
2026-08-09 chore(vscode): 添加编译下载与调试配置
2026-08-09 feat(build): 添加清理固件任务
2026-08-09 refactor(config): 更新系统包与存储配置
2026-08-09 fix(build): 修复 UFFS 与 DFS v1 编译兼容性
2026-08-09 feat(micropython): 移植 MicroPython 并适配 1 MB Flash
    修复 MicroPython 1.13 与当前 RT-Thread 的接口兼容问题，并同步 STM32F407VG 的链接、调试及工程配置。\n\n验证：scons -j8 编译通过。
    [board.h, machine_pwm.c, machine_rtc.c, machine_wdt.c, modmachine.c]
2026-08-09 fix(nlrthumb): 修复 nlr_jump 函数的内存屏障声明
2026-08-10 feat(gitignore): 添加 rt-thread 工具目录到 .gitignore
2026-08-11 refactor(rt-thread): 改用树外 v5.2.2 上游源码
    删除仓库内嵌 RT-Thread 源码，默认使用 ~/rt-thread 并支持 RTT_ROOT 覆盖。\n\n适配 v5.2.2 驱动头文件、块设备、对象名和 UFFS 缓存配置，更新 Keil 与 IAR 工程。\n\n验证：scons 构建通过；J-Link 烧录通过；串口启动、UFFS 挂载及亮屏正常。
    [kconfig-language.txt, kconfig.txt]
2026-08-21 fix(build): 调整应用起始地址至 0x08010000
2026-08-21 fix(rs485): 修复 PB8 收发方向控制
2026-08-21 fix(spi): 将闪存片选调整至 PB1
    同步 CubeMX 引脚配置，并补充使用 STM32F407VG 参数访问扩展 Flash 的 J-Link 烧录说明。
    [CubeMX_Config.ioc, main.h]
2026-08-22 feat(ui): 内置 GB2312 中文字库
    加入 16px 1bpp 的 6763 个汉字及全角标点，并在串口、文件浏览和离线下载动态文本中统一使用。英文、数字和图标继续回退到 Montserrat 12。
2026-08-22 fix(uart): 重配置前停止接收 DMA
2026-08-22 fix(download): 适配 SD 卡挂载路径
2026-08-22 fix(dap): 将 JTAG 复位引脚改为开漏输出
    [DAP_config.h]
2026-08-22 fix(uart): 支持 1.5 停止位
2026-08-22 fix(uart): 正确映射 CDC 数据位与校验位
2026-08-22 fix(download): 将下载速度从 4000 调整为 15000
2026-08-22 fix(uart): 使用循环 DMA 接收连续数据
    [CubeMX_Config.ioc]
2026-08-22 fix(dap): 修正时间戳时钟频率
2026-08-22 refactor(memory): 脱机下载改为按需分配内存
2026-08-22 refactor(uffs): 在包内维护 DFS v1 适配
    移除构建期对象过滤和 BSP 本地替代端口，直接在仓库内维护 UFFS 的 DFS v1 实现。\n\n验证：scons 构建通过。
2026-08-22 feat(shell): 增加串口 vi 文件编辑器
    启用 vi、mem_sandbox 和 optparse 软件包，并补齐所需 POSIX 组件。\n修复工程内旧版 optparse 与软件包 API 冲突，将最大编辑宽度限制为 256 以降低沙箱内存占用。
    [rtconfig.h]
2026-08-22 refactor(shell): 统一使用 optparse 软件包
    删除工程内旧版 optparse，实现 uMCN 与 vi 统一调用软件包 API。同步更新 Keil 和 IAR 工程文件。
2026-08-22 fix(lvgl): 修复文件浏览目录结束误报
    区分目录正常遍历结束与真实读取错误，并修复根目录返回时可能使用未初始化路径的问题。
2026-08-22 chore(log): 收紧固件日志输出等级
    默认仅输出严重错误，保留低等级诊断日志供需要时启用，并移除无效的 DAP 裸打印。
2026-08-22 fix(micropython): 修复 qstr 编号溢出
2026-08-22 perf(uffs): 优化 NAND 读写并降低内存占用
2026-08-22 perf(uffs): 用 OOB 扩展有效页至 2048 字节
2026-08-22 perf(uffs): 启用 NAND 硬件 ECC 并重排 OOB
    将 MiniHeader 移入受片内 ECC 保护的 OOB 区域，主数据区完整提供 2048 字节有效载荷。\n\n接入 W25N01GV ECC 状态返回，并由 UFFS 适配层管理 Tag、Seal 与 MiniHeader 的物理布局。\n\n验证：scons 构建通过；1 MiB/4 KiB 测试写入 535 KiB/s、读取 1430 KiB/s，跨复位校验通过。
2026-08-22 perf(uffs): 消除新块写入的重复读取
    新建逻辑块时直接写入已验证的擦除块，不再复用块搬迁流程申请并扫描第二个块。\n\nMiniHeader 位于 OOB 时，擦除页校验仅读取 MiniHeader 与 Tag，避免传输完整主数据区。\n\n验证：scons 构建通过；1 MiB/4 KiB 写入 1150 KiB/s，4 MiB 测试写入 1159 KiB/s，跨复位校验通过。
2026-08-22 fix(vi): 扩大编辑器内存沙箱
    将 VI 沙箱从 20 KiB 调整为 32 KiB，避免编辑 UFFS 文件时内存分配断言。
    [rtconfig.h]
2026-08-22 fix(sd): 修复 SD 卡初始化与 exFAT 挂载
    修正 SDIO 时钟源，扩大 MMCSD 检测线程栈，并避免启动阶段重复触发卡检测。启用 exFAT 以支持大容量 SDXC 卡。
    [rtconfig.h, sd_card_thread.c]
2026-08-22 fix(sd): 修复 SDIO 数据完成误超时
    改用 RT-Thread 时钟计算数据通道完成超时，避免 CPU 空循环过早结束导致 fsync 写入失败。\n同时避免关闭 SDIO 时钟时发生除零。\n\n验证：64 MiB 顺序写入、fsync、回读校验通过。
2026-08-22 feat(sd): 添加 SD 卡速度测试命令
    新增 sd_speed 命令，支持顺序写入、fsync、读取测速及内容校验。\n限制单次缓冲区为 SDIO 支持的 4 KiB，测试结束后自动删除临时文件。\n\n验证：64 MiB 写入和回读校验通过。
2026-08-22 refactor(storage): 恢复 W25Q32 存储设计
    移除 W25N01GV、UFFS 及相关工程配置，恢复 SFUD/FAL 支持，并保持 SPI Flash 片选为 PB1。
2026-08-22 fix(spi): 修复 W25Q32 DMA 超时并添加测速
    [spi_flash_init.c]
2026-08-22 feat(config): 启用 FAL、Flash FATFS 和 DAC
2026-08-22 chore(git): 排除本机调试配置和日志
2026-08-22 fix(build): 修复 MDK5 工程生成与 ARMCC 编译
    基于当前 RT-Thread 5.2.2 重新生成 MDK5 工程，并绑定 ARMCC 5.06 update 7。
    修正 vi 软件包对 __CC_ARM 的编译器判断，保留 GCC 内存屏障实现。
    验证：Keil 全量编译通过，0 个错误。
2026-08-23 fix(build): 默认使用 AC6 并兼容多编译器构建
    清理生成工程中的 AC5 专用文件级参数，统一 GCC 与 AC6 的 GNU99 配置。
    将 UI 中文字符串改为显式 UTF-8 字节转义并保留原文注释，避免 BOM 和源码字符集差异。
    更新并重新生成默认 AC6 的 Keil 工程，采用体积优化配置。
2026-08-25 在 BSP 内切换 MDK5 到 AC6
2026-08-25 fix(build): 对齐 Keil 与 GCC 链接布局
2026-08-25 chore(git): 停止跟踪 JLink 日志文件
2026-08-26 refactor(spi): 优化 SPI 传输逻辑，调整 DMA 发送长度处理 refactor(config): 移除不必要的 FAL 配置项
2026-09-17 feat(storage): 将 W25Q32 整片接入 LittleFS
    移除旧 FAL 分区方案，将全部 4 MiB 用作 LittleFS 并挂载到 /fal。通过配置生成 rtconfig.h，使用 pkgs 引入 LittleFS v2.11.2 并重新生成 MDK5 工程。
    启用 LittleFS 时条件编译排除整片测速函数和命令，补充首次格式化及挂载说明。
    验证：GCC 构建通过；Keil ARM Compiler 6.16 编译通过，0 错误、8 警告。尚未进行硬件验证。
2026-09-17 fix(flash): 修复外部 Flash 缺失时的空指针异常
    W25Q32 不存在或未初始化时跳过 LittleFS 挂载，并使 FAL 读写擦除接口返回错误。设置重试回调前增加设备检查。
    验证：Keil 编译 0 错误、0 警告；实板三个接口返回 -1，断电重启未重现 HardFault，固件回读校验通过。SCons 仍受现有汇编参数兼容问题影响。
    [drv_filesystem.c, spi_flash_init.c]
2026-09-17 fix(build): 修正 TinyUF2 STM32F4 的系列标识
