czstara12/lckfb-daplink/(notices)

Notices in the files:
1_Code/STM32F407/board/CubeMX_Config/Inc/main.h:
Copyright (c) 2024 STMicroelectronics.
All rights reserved.
This software is licensed under terms that can be found in the LICENSE file
